alexlanni/solar-assistant-cyd/enclosure/preview/preview_front_inside.png

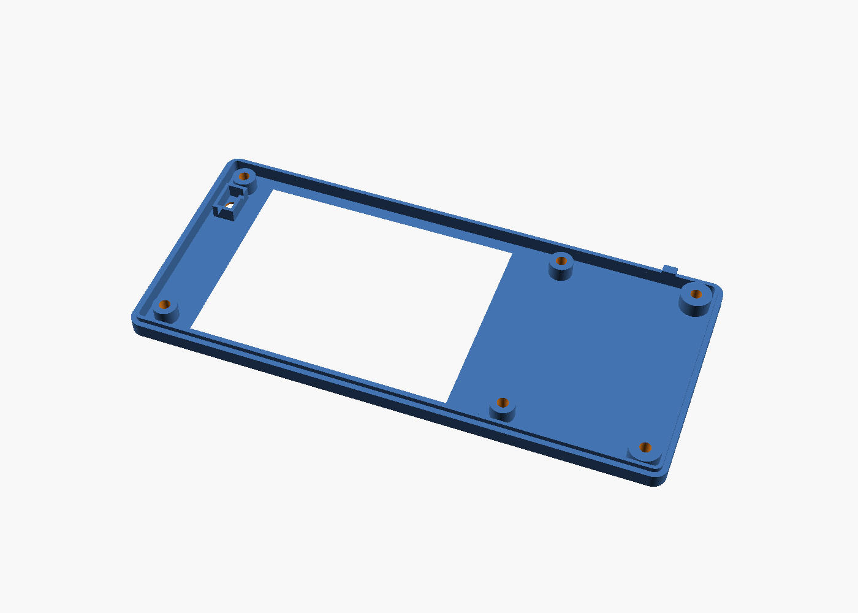
enclosure/preview/preview_front_inside.png
