alexlanni/solar-assistant-cyd/enclosure/preview/preview_front_ortho.png

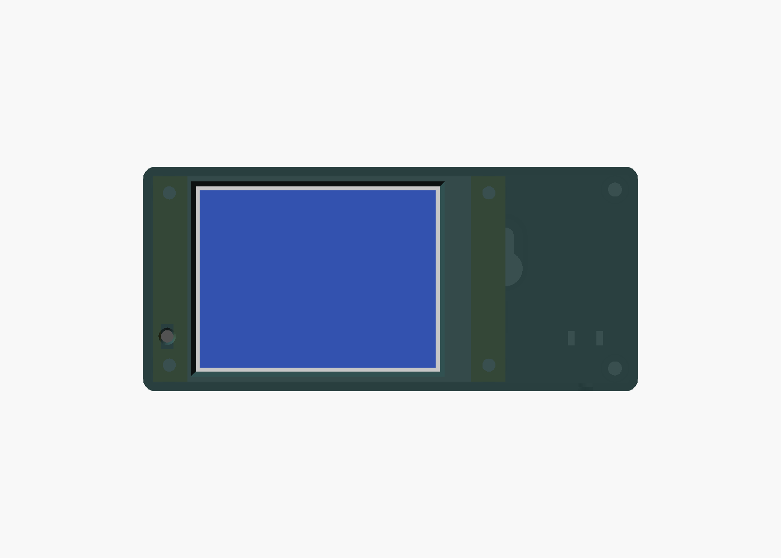
enclosure/preview/preview_front_ortho.png
