alexlanni/solar-assistant-cyd/enclosure/preview/preview_stand.png

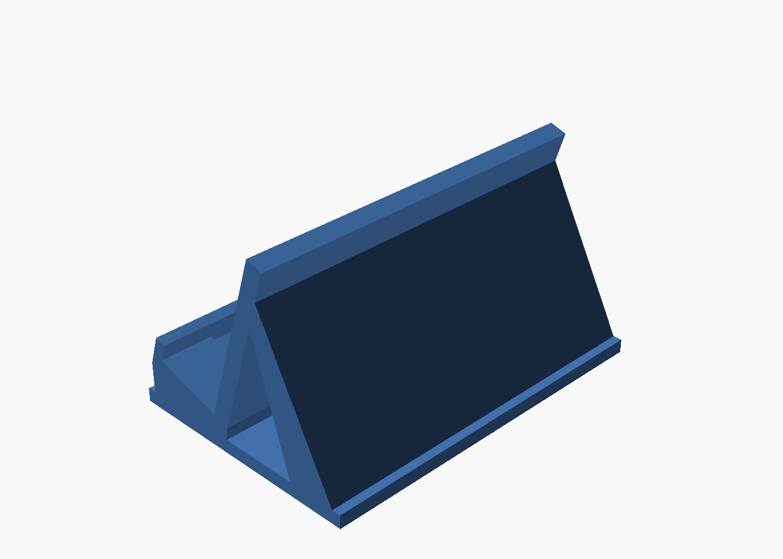
enclosure/preview/preview_stand.png
