alexlanni/solar-assistant-cyd/enclosure/cyd_diffuser.stl

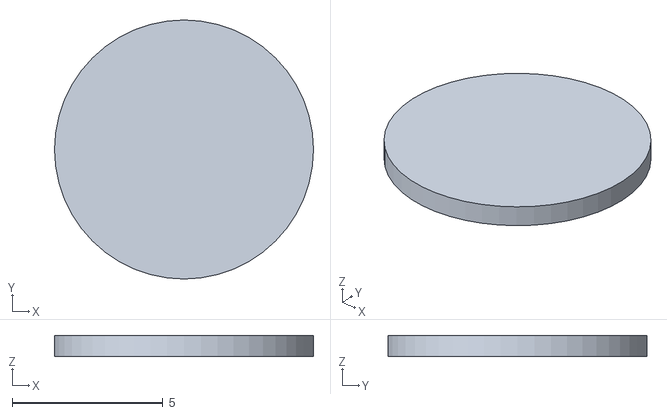
[picture p13: CAD file, 2026-10-20]
enclosure/cyd_diffuser.stl
8.60 x 8.60 x 0.7
