alexlanni/solar-assistant-cyd/enclosure/cyd_back.stl

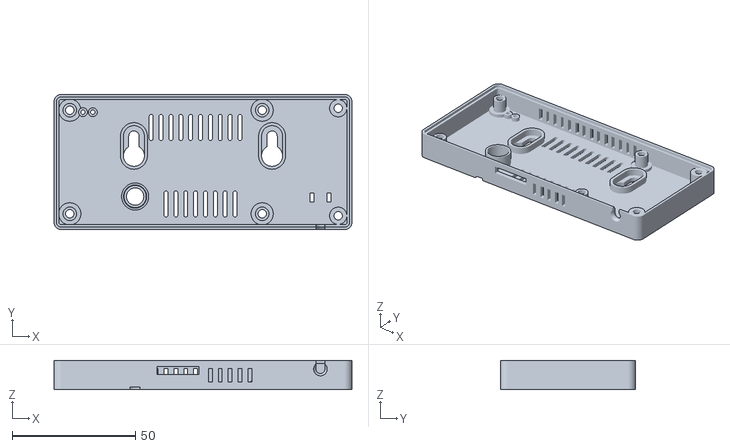
[picture p14: CAD file, 2026-10-20]
enclosure/cyd_back.stl
120.8 x 54.8 x 11.8
