alexlanni/solar-assistant-cyd/enclosure/cyd_front.stl

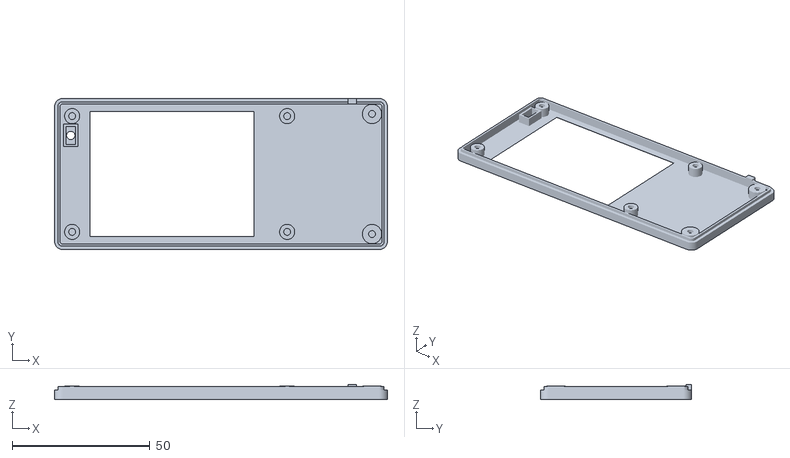
[picture p15: CAD file, 2026-10-20]
enclosure/cyd_front.stl
120.8 x 54.8 x 5.40
