alexlanni/solar-assistant-cyd/enclosure/cyd_stand.stl

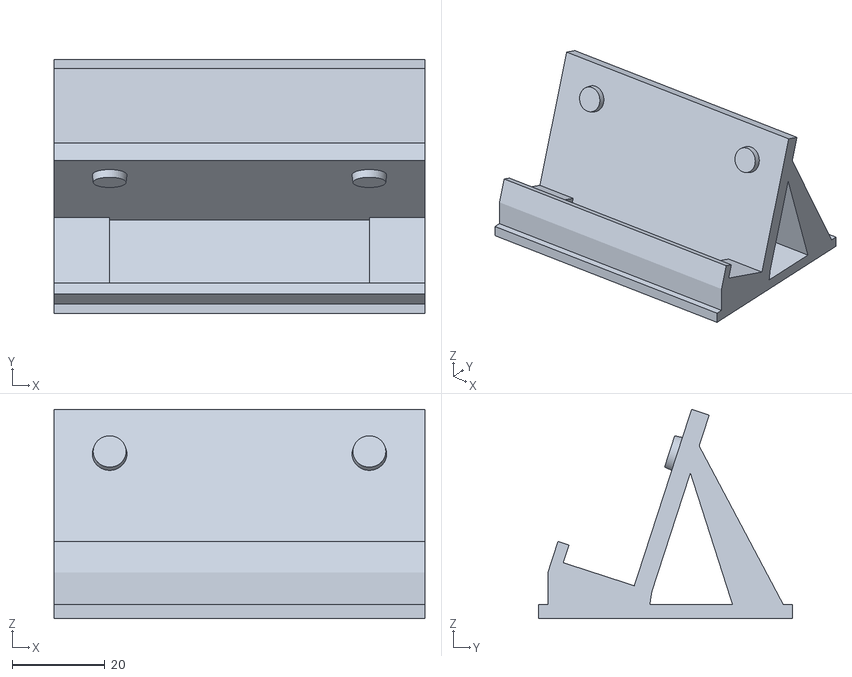
[picture p16: CAD file, 2026-10-20]
enclosure/cyd_stand.stl
80.0 x 54.9 x 45.1
