alexlanni/solar-assistant-cyd/include/secrets.example.h

#pragma once
// Credenziali e indirizzi – questo file è escluso da git (.gitignore)

const char*    WIFI_SSID = "TUO_WIFI";
const char*    WIFI_PASS = "TUA_PASSWORD";

const char*    MQTT_HOST = "192.168.1.161";   // Solar Assistant
const uint16_t MQTT_PORT = 1883;
const char*    MQTT_USER = "";                // vuoto = connessione anonima
const char*    MQTT_PASS = "";
