alexlanni/solar-assistant-cyd/(commit log)

2026-10-20 Commit versione v1.0 funzionante e testata con tre pagine
    [cyd_back.stl, cyd_diffuser.stl, cyd_enclosure.scad, cyd_front.stl, cyd_stand.stl]
2026-10-23 Aggiunto Voltaggio batteria. Utile per capire quando scattano i limiti dell'inverter.
2026-10-23 Aggiornamento Immagini di esempio
